steefbrown/pixelperfect/Application/MainController/MainController/bin/Debug/received_image_scott.jpg

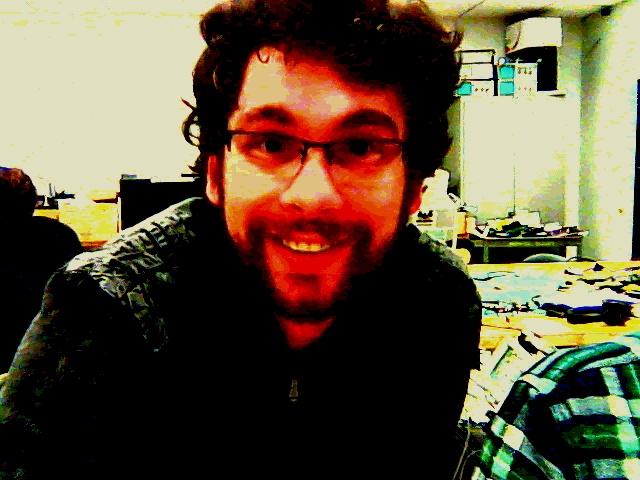
Application/MainController/MainController/bin/Debug/received_image_scott.jpg
