steefbrown/pixelperfect/Specification/diagram_phone.jpg

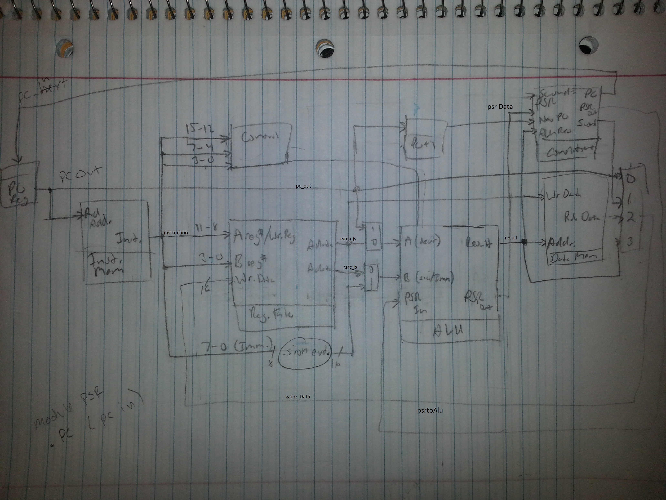
Specification/diagram_phone.jpg
