steefbrown/pixelperfect/Specification/Poster_Final_PixelPerfect.pdf

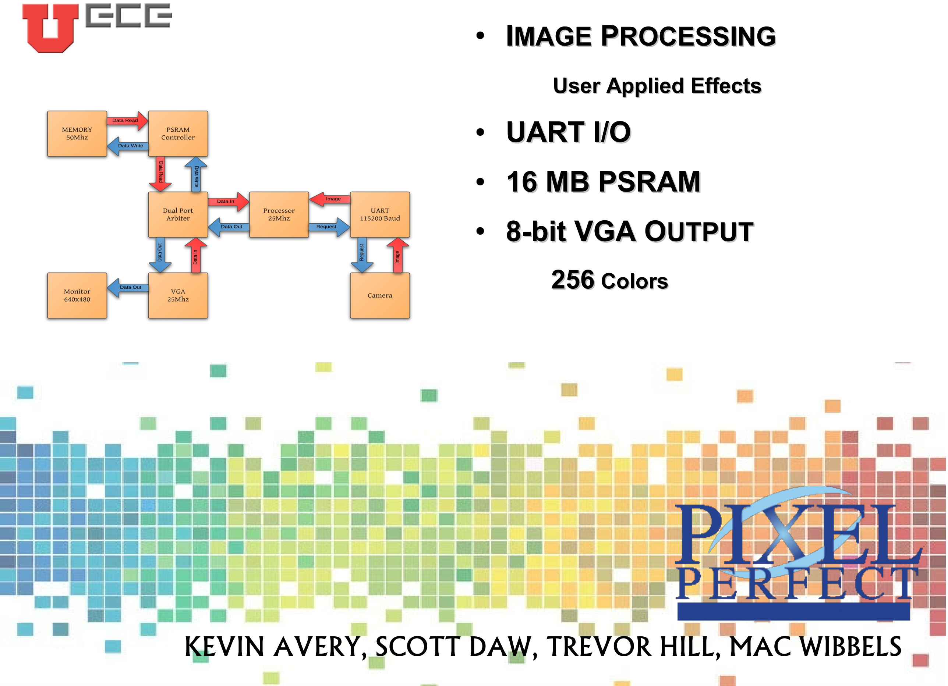
[picture p3: page 1]

●

IMAGE PROCESSING

User Applied Effects
- UART I/O
- 16 MB PSRAM
- 8-bit VGA OUTPUT

256 Colors

KEVIN AVERY, SCOTT DAW, TREVOR HILL, MAC WIBBELS
