steefbrown/pixelperfect/Specification/Presentation.pdf

# PixelPerfect

Kevin Avery, Scott Daw,
Mac Wibbels, Trevor Hill

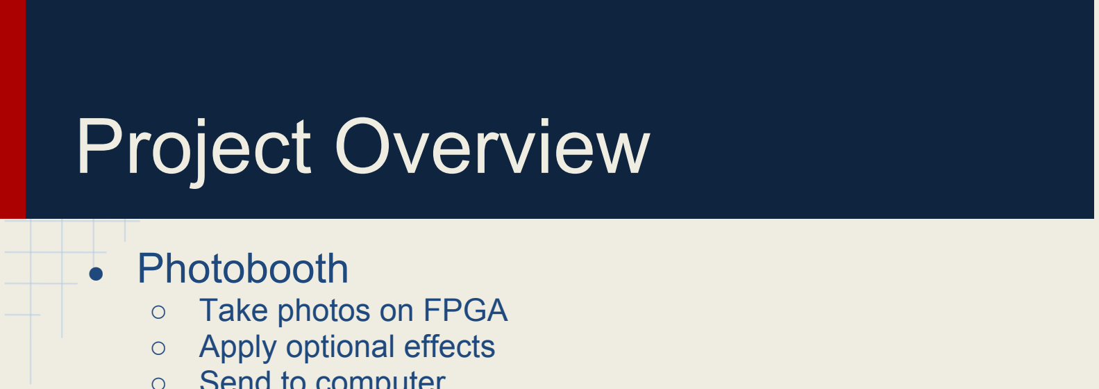
[picture p4: figure]
Project Overview; ● Photobooth; ○ Take photos on FPGA ○ Apply optional effects

- Send to computer
■ Print or post online

## - Outline

1. Application
2. I/O
3. Assembler
4. Processor

# Application

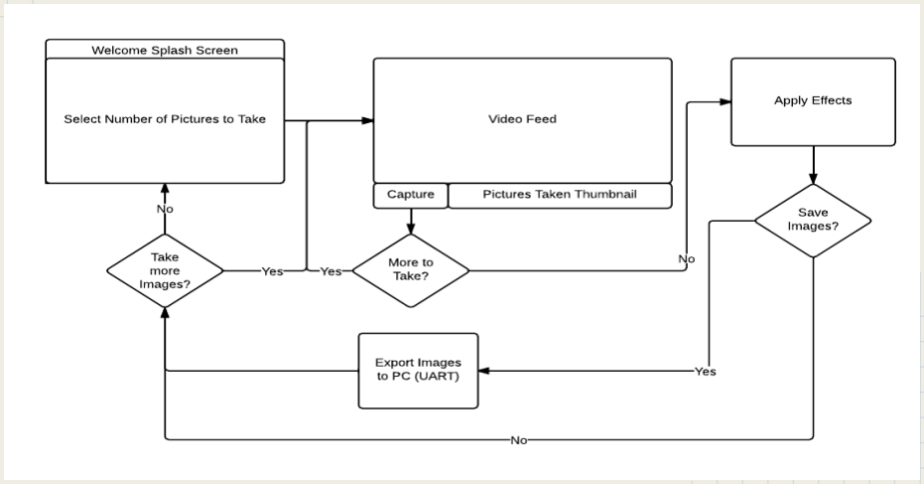
[picture p5: figure]

I/O

## - RAM

## - VGA

## - UART

## - Camera

## - Interface Buttons

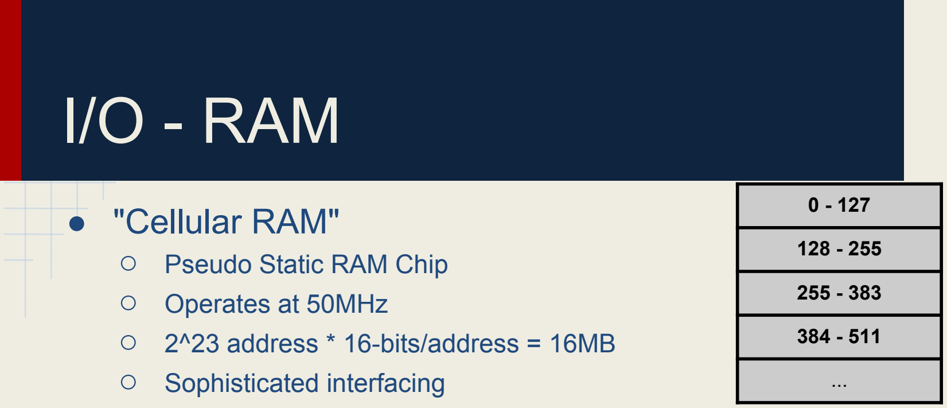
[picture p6: figure]
I/O - RAM; ● "Cellular RAM"; ○ Pseudo Static RAM Chip; ○ Operates at 50MHz; ○ 2^23 address * 16-bits/address = 16MB; ○ Sophisticated interfacing

■ Burst reads/writes up to 128 addresses (1 physical RAM line)

## - Used for full direct mapped screen frame buffer

- 320 * 240 * 16-bits ~= 1.2MB
- 2 pixels per address

## - Also used for program stack and heap

- Need to arbitrate between VGA burst reading,

## processor read/writing, camera burst writing

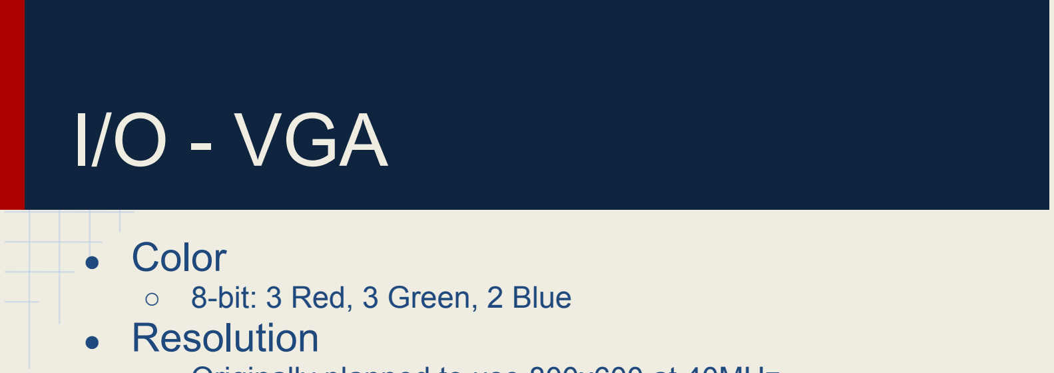
[picture p7: figure]
I/O - VGA; ● Color; ○ 8-bit: 3 Red, 3 Green, 2 Blue ● Resolution

- Originally planned to use 800x600 at 40MHz
- Caused timing related fuzziness/artifacts
- Switched to 640x480 at 25MHz - life is good

## - Buffered video pipeline

- 1024 pixel dual-ported BRAM buffer
- Burst read from RAM at 50MHz
- Drawn to screen at a 25MHz
0 - 127 | 128 - 255 | 256 - 383 | 384 - 511

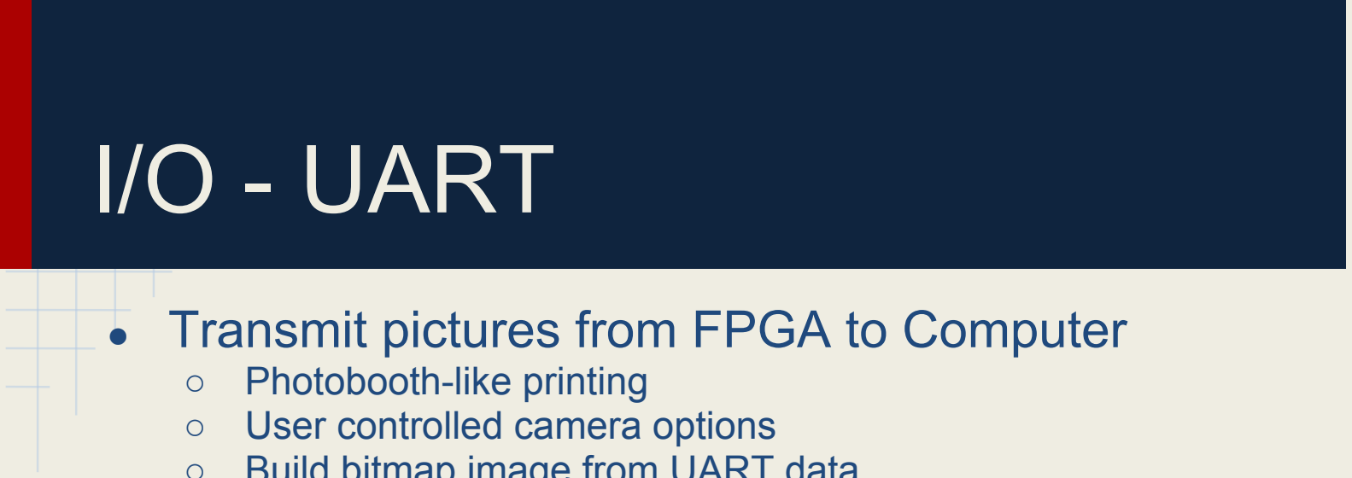
[picture p8: figure]
I/O - UART; ○ Photobooth-like printing ○ User controlled camera options

## - Transmit pictures from FPGA to Computer

- Build bitmap image from UART data

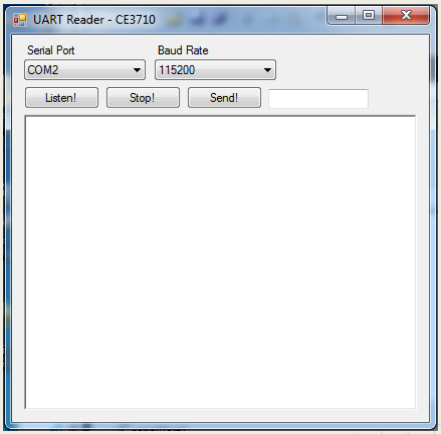
[picture p9: figure]

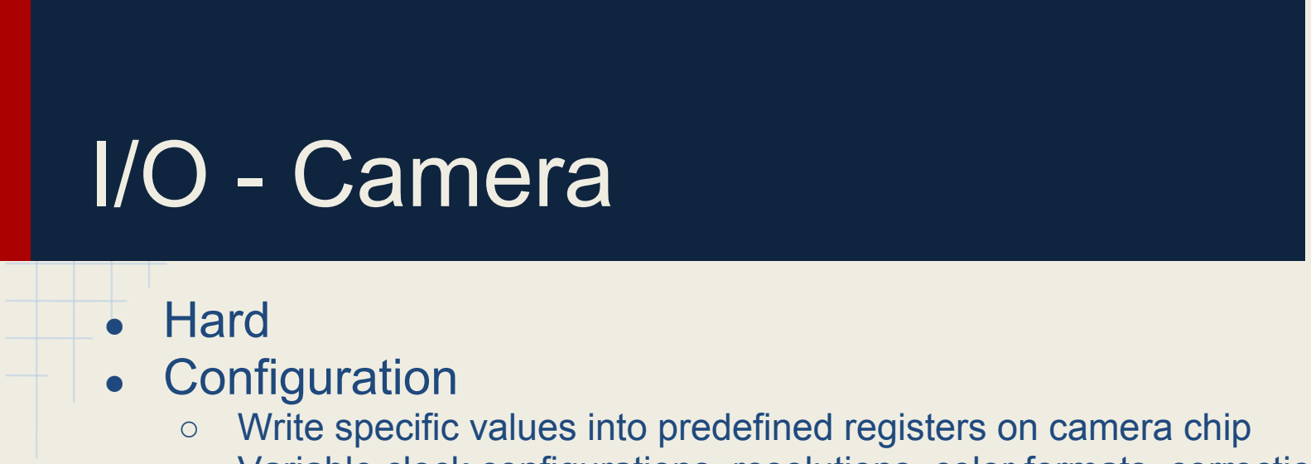
[picture p10: figure]
I/O - Camera; ● Hard ● Configuration

- Write specific values into predefined registers on camera chip
- Variable clock configurations, resolutions, color formats, correction options, more...
- I2C two-wire interface

## - Buffering

- Sync data from camera pixel clock with RAM clock
- Burst write when VGA not burst reading

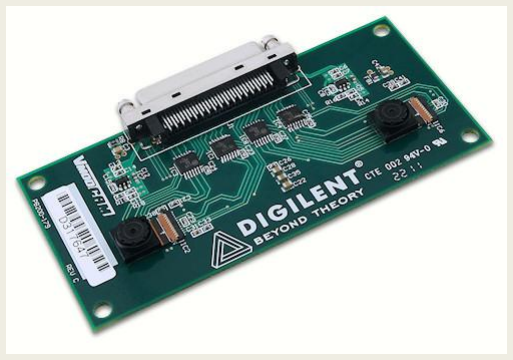
[picture p11: figure]

# Processor

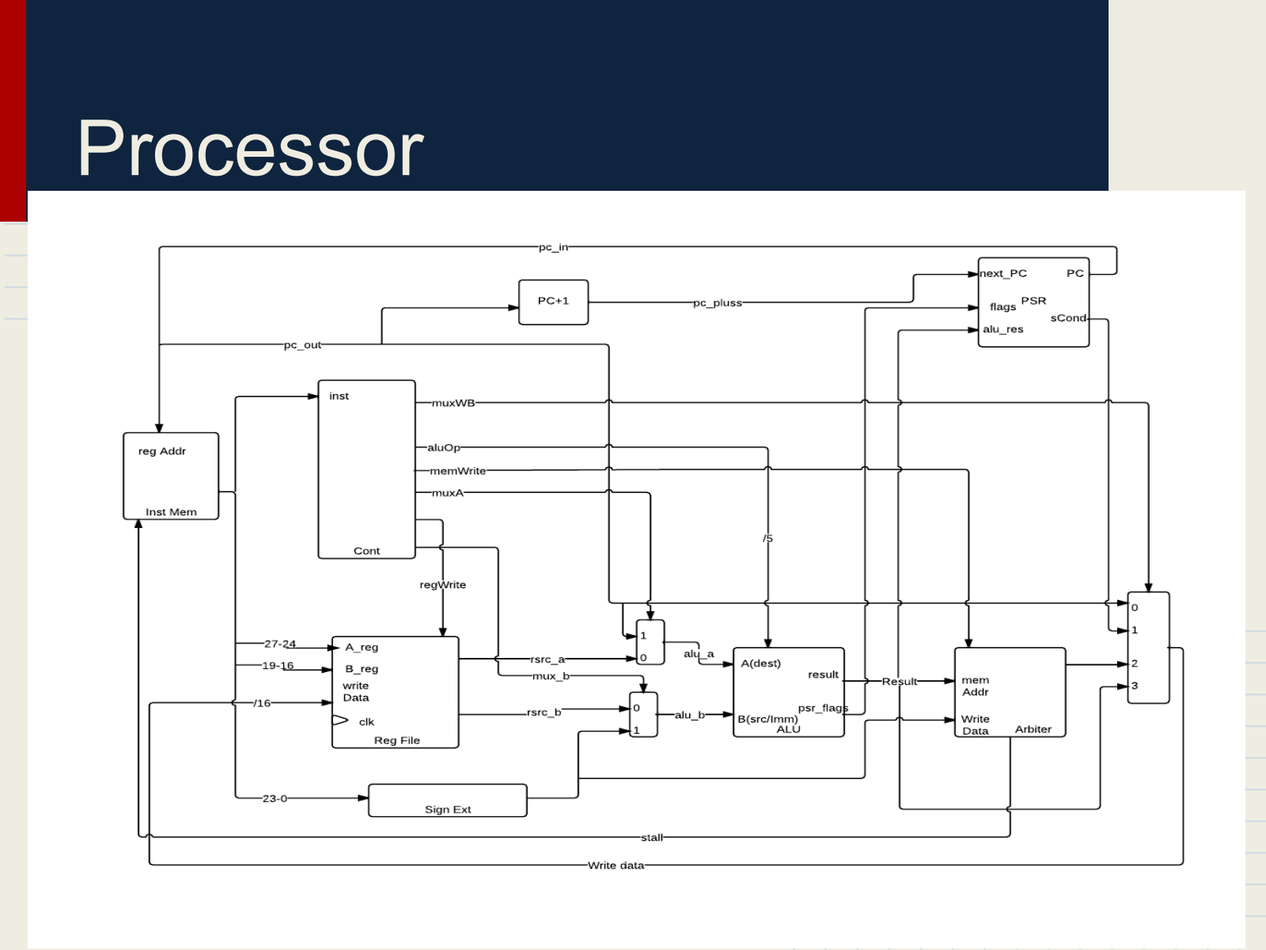
[picture p12: page 9]

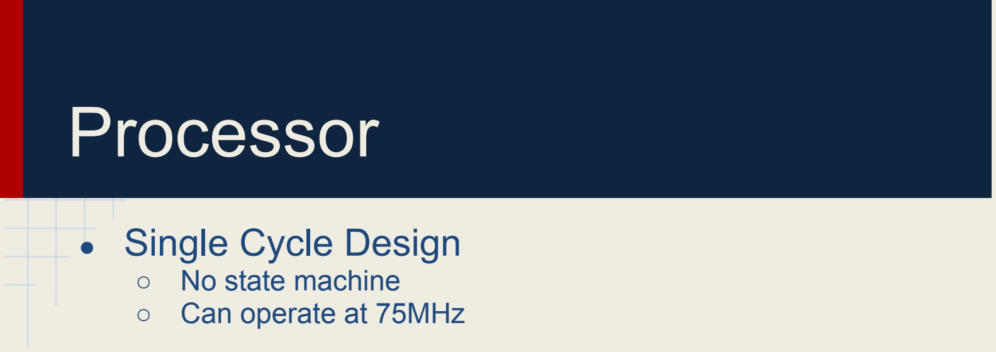
[picture p13: figure]
Processor; ● Single Cycle Design; ○ No state machine ○ Can operate at 75MHz

## - Extended datapath to 32-bit

- Using 16 bits allows for 64K addresses
- Single image frame is 75K addresses
- I-type instructions now have 24 bit immediates allowing for addressing to all 8Meg addresses of RAM
- Extra upper bits are used for memory mapped I/O as needed

## - Uses stalls

- Multiple applications accessing memory
- Fixed VGA checkering effects

# Assembler

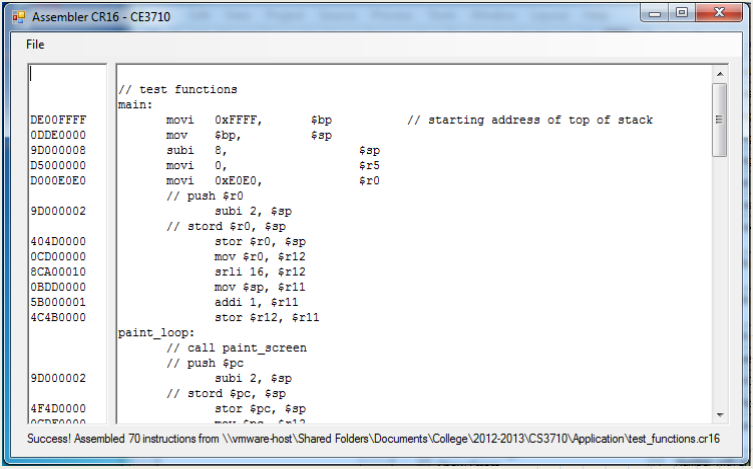
[picture p14: figure]

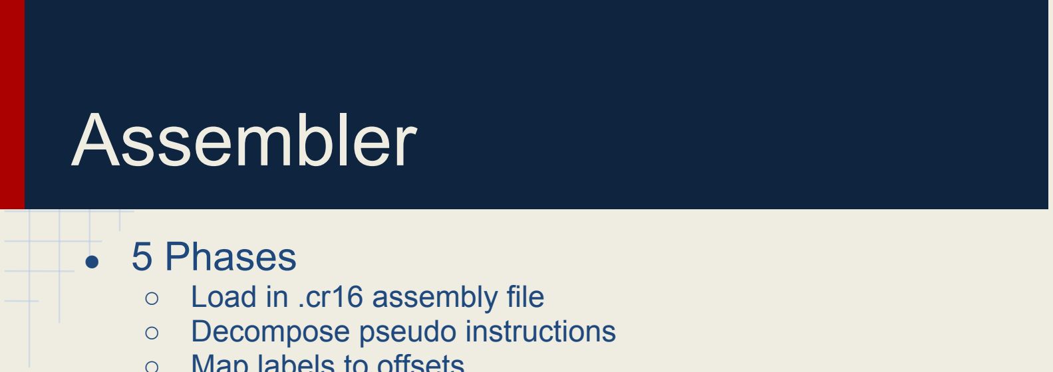
[picture p15: figure]
Assembler; ● 5 Phases; ○ Load in .cr16 assembly file ○ Decompose pseudo instructions

- Map labels to offsets
- Encode mnemonic instructions to hex
- Write hex instructions to .dat or .coe

## - Customized ISA

- Added several pseudo instructions for function calling/stack manipulation
- Simplified shift commands
- Removed unnecessary ADDC/SUBC commands
to free up OP-codes
- Expanded to support 32 bit instructions

# Questions?
