steefbrown/pixelperfect/Specification/Flowchart.png

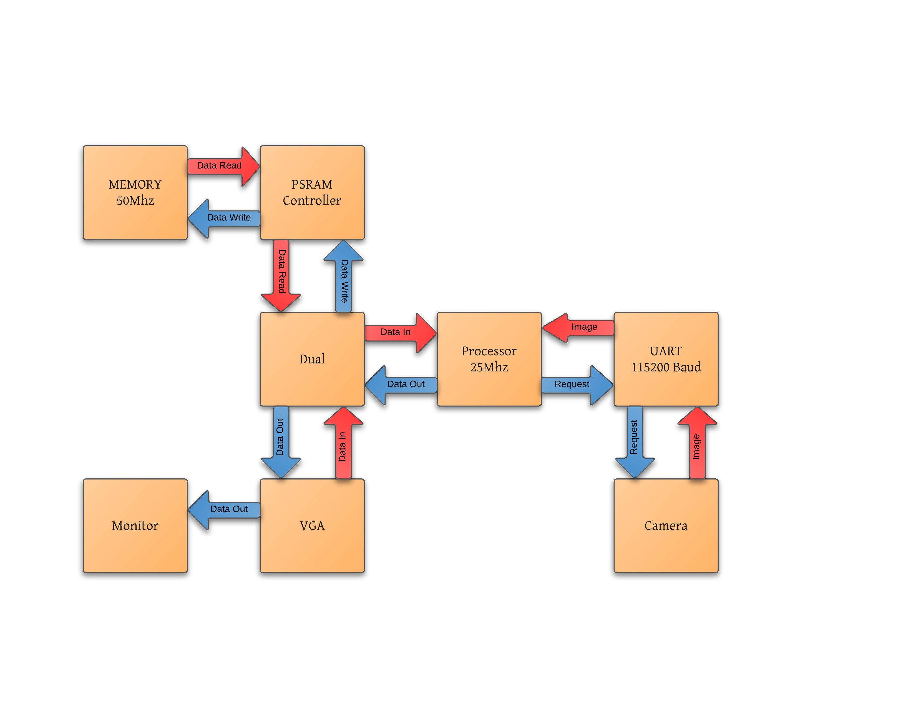
Specification/Flowchart.png
