steefbrown/pixelperfect/Specification/highlevel_schematic.png

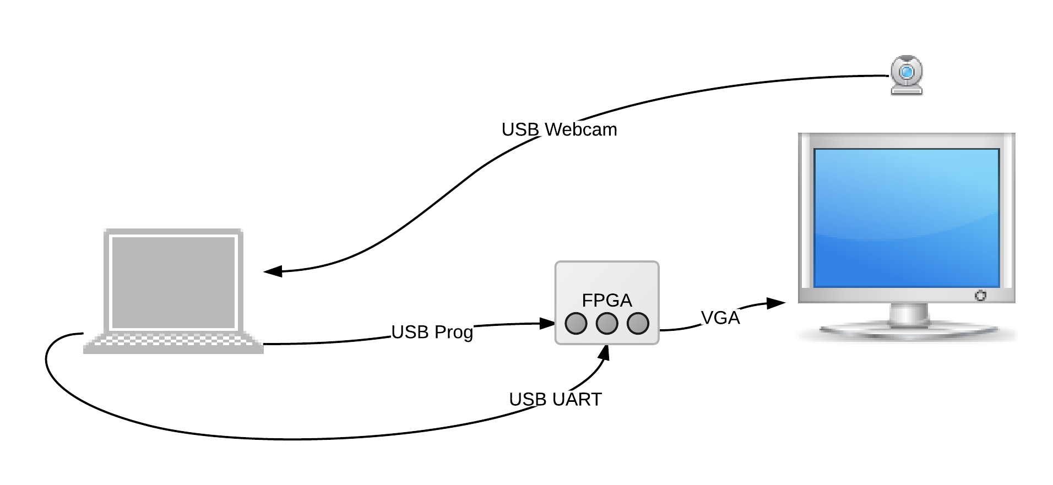
Specification/highlevel_schematic.png
