steefbrown/pixelperfect/Specification/processor_schematic.jpg

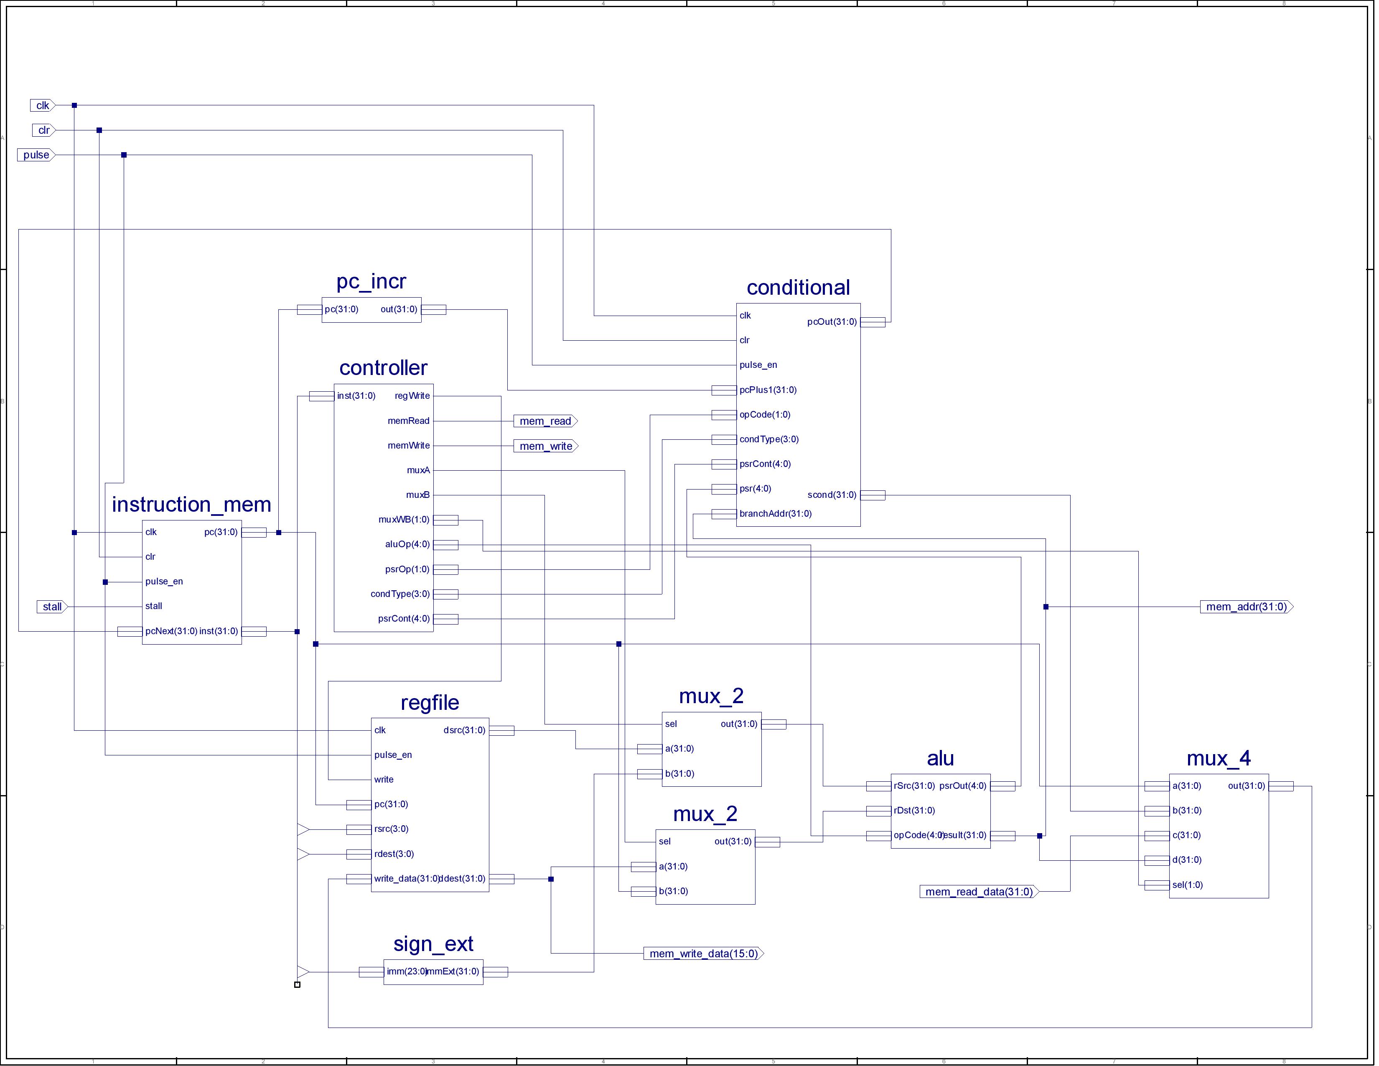
Specification/processor_schematic.jpg
