steefbrown/pixelperfect/Specification/system_schematic.jpg

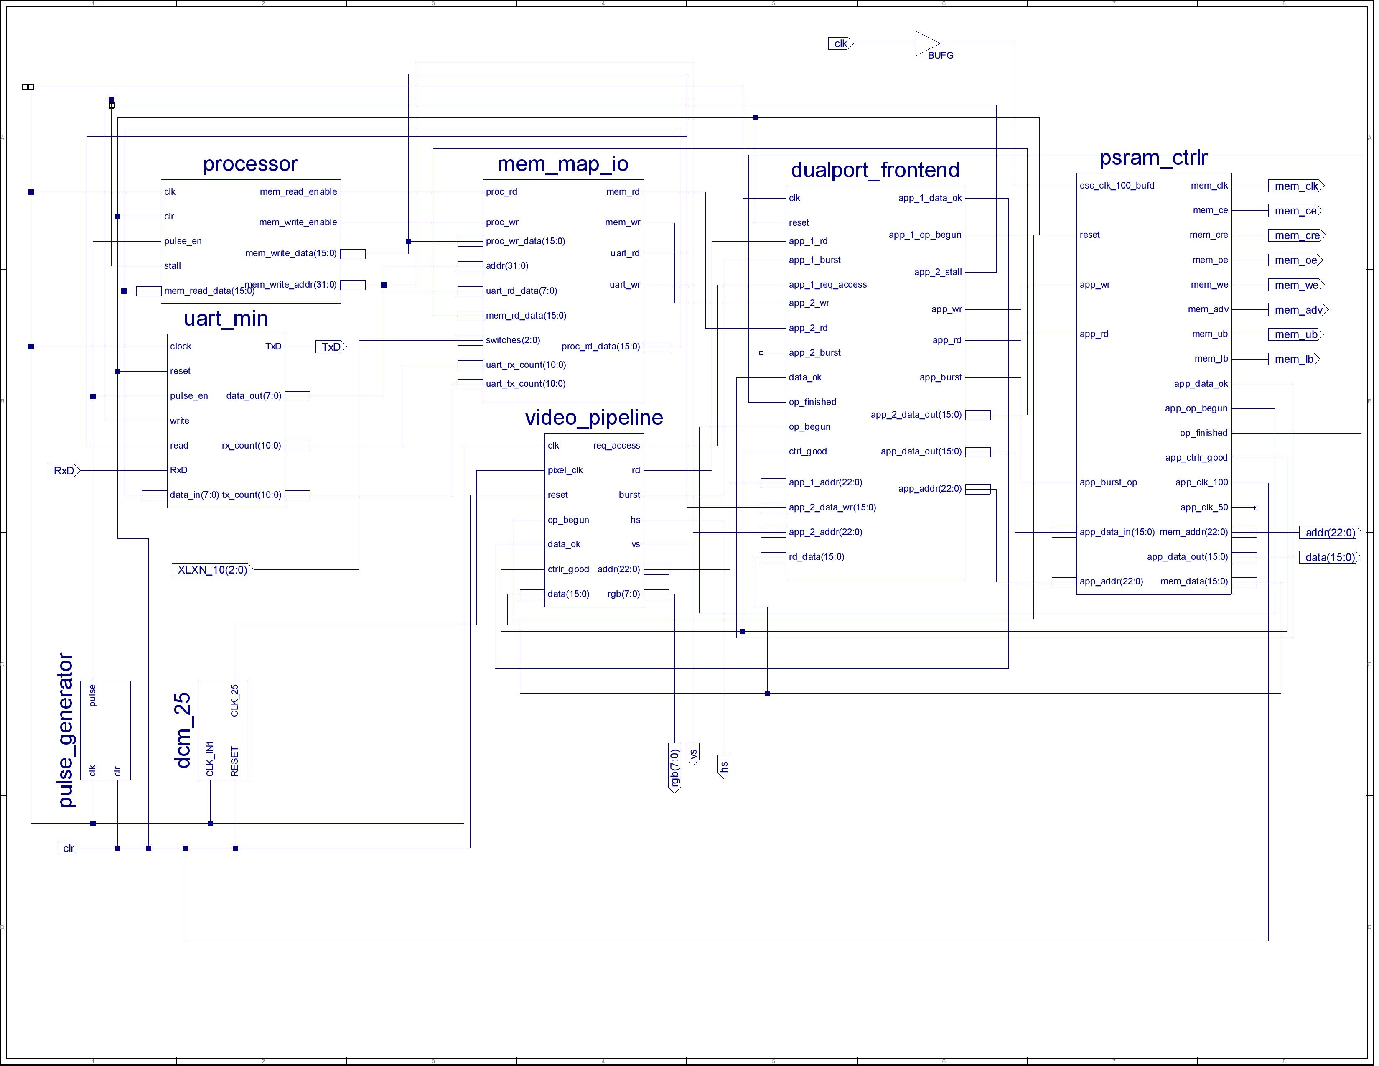
Specification/system_schematic.jpg
