steefbrown/pixelperfect/Application/MainController/MainController/bin/Debug/received_image_paymon_meyers.jpg

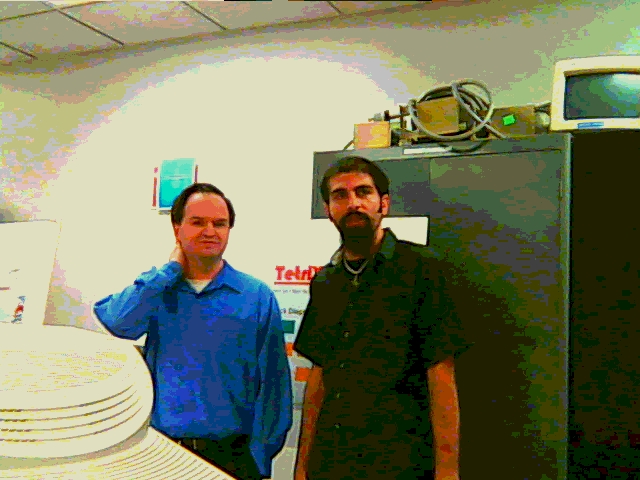
Application/MainController/MainController/bin/Debug/received_image_paymon_meyers.jpg
